d-haldane/nyan-bow/source/NAYN/nyan.kicad_pcb

## KiCad design source/NAYN/nyan.kicad_pcb (2022-06-29)

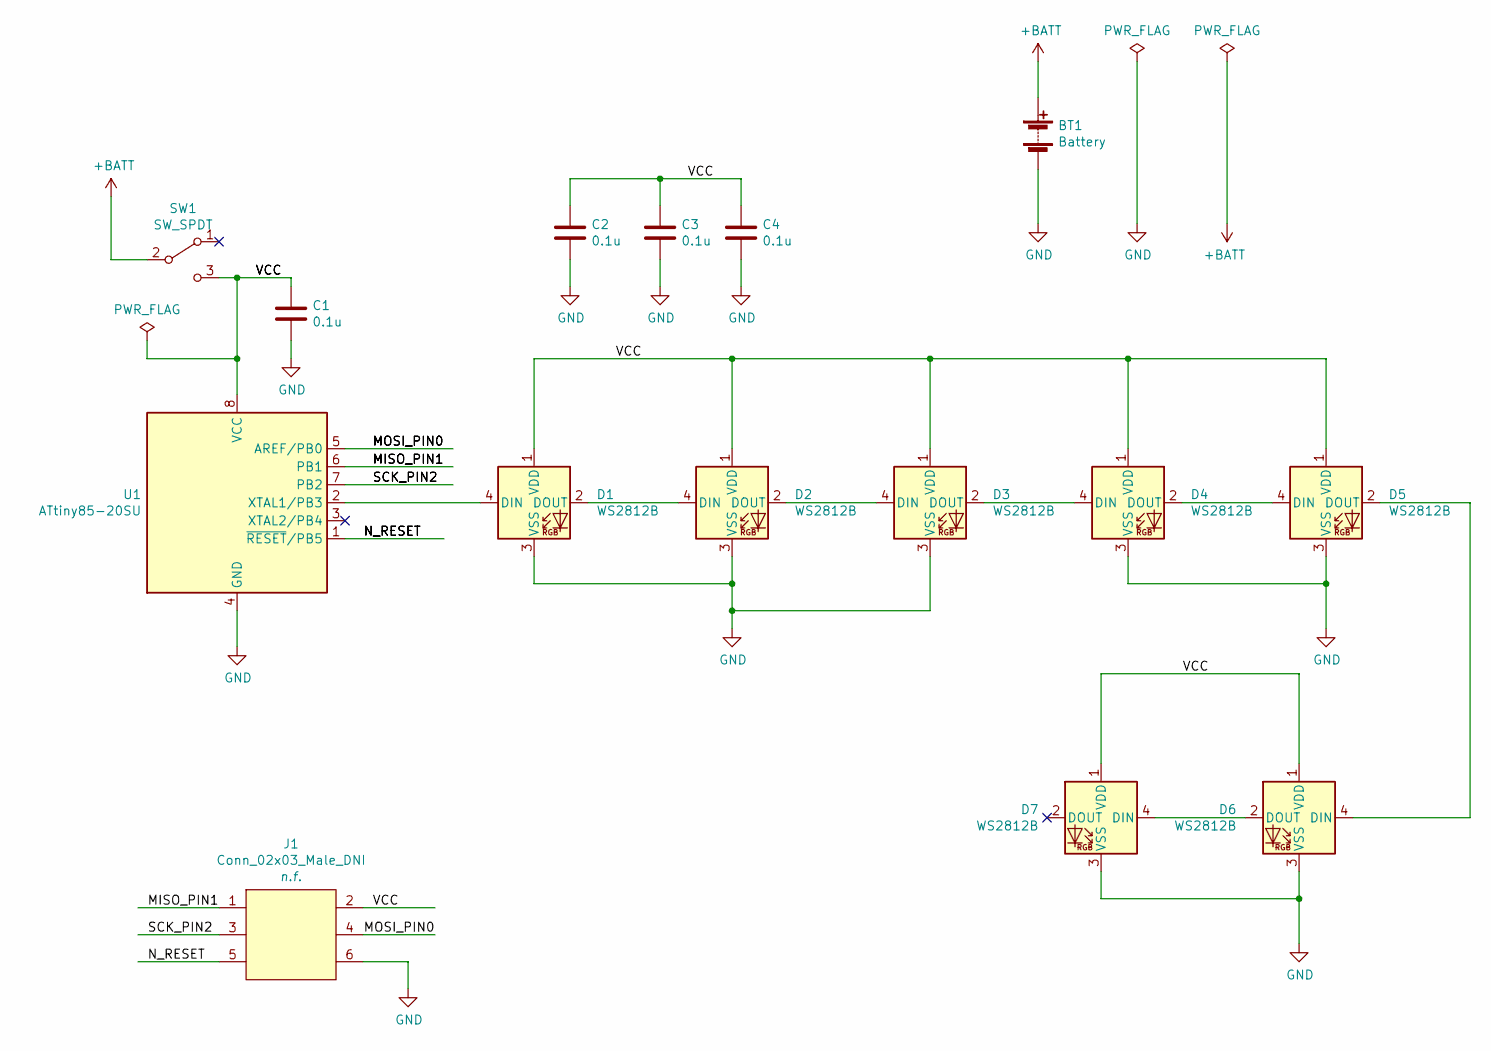
[picture p1: schematic nyan.sch]

Parts:
BT1: Battery; JST_PH_S2B-PH-SM4-TB_1x02-1MP_P2.00mm_Horizontal
C1, C2, C3, C4: 0.1u; C_0805_2012Metric_Pad1.15x1.40mm_HandSolder
D1, D2, D3, D4, D5, D6, D7: WS2812B; LED_WS2812B_mini3535
J1: Conn_02x03_Male_DNI; PinHeader_2x03_P2.54mm_Vertical_SMDcircular
SW1: SW_SPDT; SW_SPDT_PCM12_SMDHOLE
U1: ATtiny85-20SU; SOIJ-8_5.3x5.3mm_P1.27mm

Connections:
+BATT: BT1.1 (+), SW1.2 (B)
/MISO_PIN1: J1.1, U1.6 (PB1)
/MOSI_PIN0: J1.4, U1.5 (AREF/PB0)
/N_RESET: J1.5, U1.1 (~RESET~/PB5)
/SCK_PIN2: J1.3, U1.7 (PB2)
/VCC: C1.1, C2.1, C3.1, C4.1, D1.1 (VDD), D2.1 (VDD), D3.1 (VDD), D4.1 (VDD), D5.1 (VDD), D6.1 (VDD), D7.1 (VDD), J1.2, SW1.3 (C), U1.8 (VCC)
GND: BT1.2 (-), C1.2, C2.2, C3.2, C4.2, D1.3 (VSS), D2.3 (VSS), D3.3 (VSS), D4.3 (VSS), D5.3 (VSS), D6.3 (VSS), D7.3 (VSS), J1.6, U1.4 (GND)
unnamed: D1.2 (DOUT), D2.4 (DIN)
unnamed: D1.4 (DIN), U1.2 (XTAL1/PB3)
unnamed: D2.2 (DOUT), D3.4 (DIN)
unnamed: D3.2 (DOUT), D4.4 (DIN)
unnamed: D4.2 (DOUT), D5.4 (DIN)
unnamed: D5.2 (DOUT), D6.4 (DIN)
unnamed: D6.2 (DOUT), D7.4 (DIN)

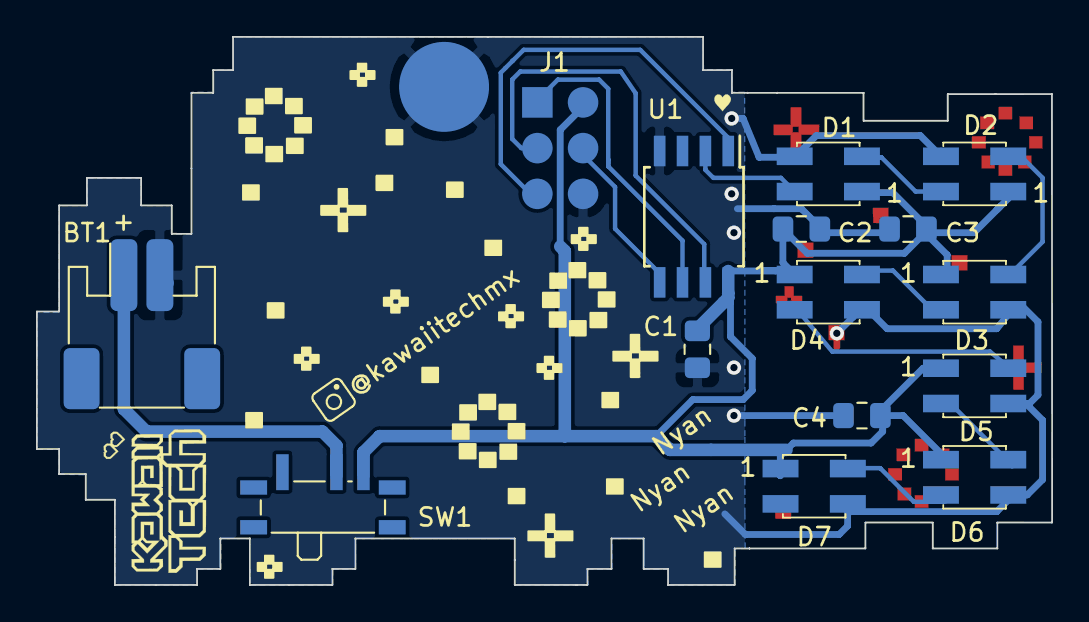
[picture p2: board nyan.kicad_pcb from below]

Board: 2 copper layers, 56.4 x 30.4 mm, 20 parts (19 on the bottom side), 14 nets.

Other parts of the board:
Ref**: Val**; nyancat
Ref**#2: Val**; pinIndicatorHeart
svg2mod: G***; instagram
svg2mod#2: G***; logoCorazones
svg2mod#3: G***; KawaiiTechLogo
