d-haldane/nyan-bow/(commit log)

2022-07-01 Adding imports, most LEDs are arranged.
    [CAD.kicad_pcb, CAD.sch, NAYN.kicad_pcb]
2023-05-09 Big reorg. Submodule hackathon
    [CAD.kicad_pcb, CAD.sch, NAYN.kicad_pcb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]
